HK509/CM3070/README.md

# CM3070 - Final Project

## A.E.R.O - Aqua and Ember Relief Operations: An IoT Platform for Monitoring, Managing, Mitigating and Communicating Floods, Wildfires and Drought 
8.2 Project Idea 2: Towards a Low-cost Resilient Early-warning Natural 
Disaster Monitoring, Notification and Rapid Response Platform
