HK509/CM3070/Test Reports/Sprint 1 Test Cases.docx

Sprint 1 Test Cases

Hardware Assembly - Hardware and Integration Tests

To ensure components are being handled correctly by the ESP8266 microcontrollers for each node

Node 1 – Sensor Node
Test ID | Feature | Test Action | Expected Result | Pass/ Fail
TC - 01 | Ultrasonic sensor (water level sensor) | Place an object exactly 10cm away from the sensor. | The serial monitor prints a reading of 10cm (± 1cm) | PASSED
TC - 02 | Ultrasonic sensor (water level sensor) | Take a reading from the ultrasonic sensor. Fill the water container with 5cm more water. | The serial monitor shows a reading of 5cm increase in water level (distance is 5cm less than original as water level is now 5cm closer to sensor)
TC - 03 | DHT11 – Temperature and Humidity Sensor (Temperature) | Check current room temperature. Print the DHT11 temperature reading to serial monitor | The current room temperature and DHT11 temperature should be the same (± 2°C) | PASSED
TC - 04 | DHT11 – Temperature and Humidity Sensor (Temperature) | Print the DHT11 temperature reading to serial monitor. Then turn on the heating element of fan heater 1m away from the sensor for 2 minutes. | Sensor temperature readings should gradually increase over the two minutes.
TC - 05 | DHT11 – Temperature and Humidity Sensor (Humidity) | Check current room humidity. Print the DHT11 humidity reading to serial monitor | The current room humidity and DHT11 humidity should be the same (± 5%) | PASSED
TC - 06 | DHT11 – Temperature and Humidity Sensor (Humidity) | Print the DHT11 Humidity reading to serial monitor. Then turn on the heating element of fan heater 1m away from the sensor for 2 minutes. | Sensor humidity readings should gradually decrease over the two minutes.
TC-07 | Capacitive Soil Moisture Sensor | Insert capacitive soil moisture sensor in the soil of a dry, not watered plant | Serial Monitor displays a high reading
TC-08 | Capacitive Soil Moisture Sensor | Insert capacitive soil moisture sensor in the soil of a healthy watered plant | Serial Monitor displays a normal reading

Node 2 – Mitigation Node
TC - 09 | Servo Motor (floodgate) | The floodgate (through servo) should initially be disabled | The servo should be at position 0° (off/ deactivated) | PASSED
TC - 10 | Servo Motor (floodgate) | Flash a command to force the servo to open | The servo should be at position 90° (enabled/ activated) | PASSED
TC - 11 | Pump relay (for irrigation system) | Submerge the pump in water and enable the pump | The pump relay should pump water through the tubes and out into the desired container

Node 3 – Alerting Node
TC - 12 | I2C LCD Display | Initialise the display and write “Alert Node” to row 0 | The display clearly renders the text without corruption | PASSED
TC - 13 | Buzzer | Enable the alarm siren and warning alert beep functions | The buzzer should generate loud alarm sounds | PASSED
TC - 14 | LEDs (Status indicators) | Three steps: • Activate the green LED pin HIGH, and both Yellow and red LED pins LOW • Activate the yellow LED pin HIGH, and both green and red LED pins LOW • Activate the red LED pin HIGH, and both green and yellow LED pins LOW | The green LED turns on whilst yellow and red LEDs are off, then the yellow LED turns on whilst green and red LEDs are off, and finally the red LED turns on where the green and yellow LEDs turn off | PASSED

Notes/ Findings

• Mitigation node – both servo and water pump fought for power. When pump is activated for irrigation, then servo for the floodgate begins ‘glitching’. This is because even if the servo (floodgate) position is set, it uses power to remain in that constant position. This was overcome by temporarily disconnecting the servo from its pins (through code) when the irrigation is activated and pump is enabled. Once the irrigation/ water pump has been deactivated, the servo (floodgate) is reconnected to its pins through code. This seems to work, but it means both floodgate and irrigation cannot be activated at the same time. For future: an external power source is required for the irrigation system water pump.

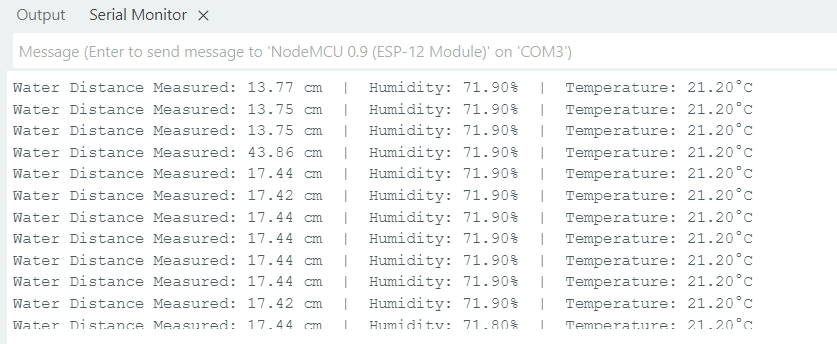
[picture p1: figure]
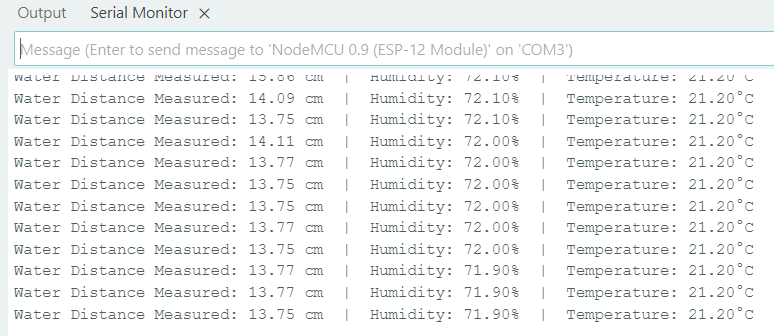
[picture p2: figure]
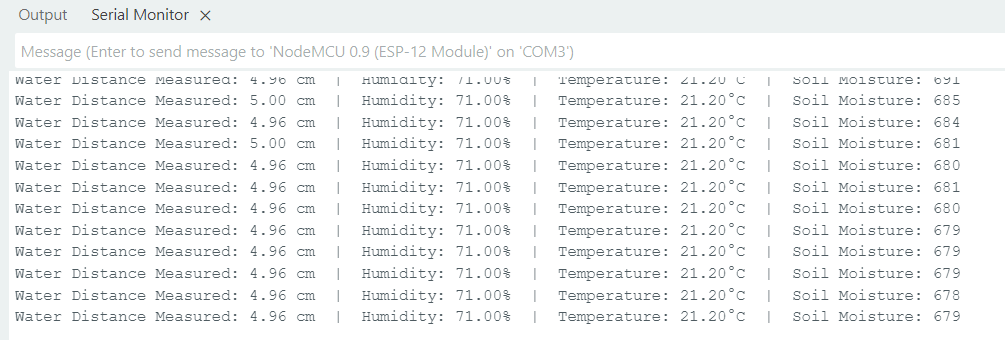
[picture p3: figure]
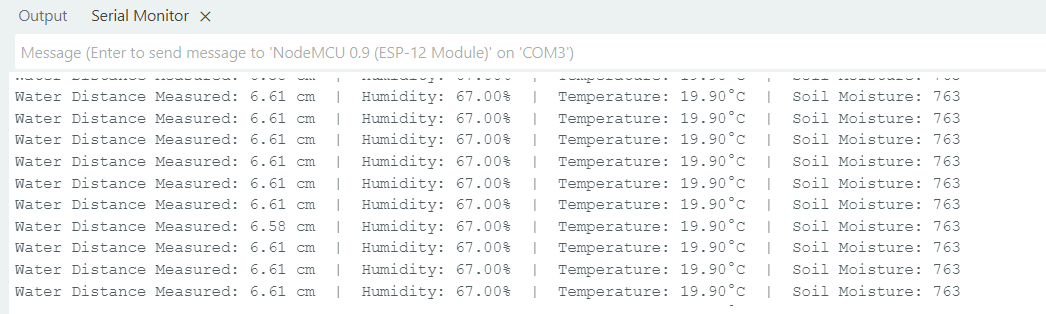
[picture p4: figure]
