HK509/CM3070/Test Reports/Sprint 2 Test Cases.docx

Sprint 2 Test Cases

ESP-NOW Communication – Functional Integration and Logic Tests

To ensure communication is being handled correctly by the ESP8266 microcontrollers for each node

Node 1 – Sensor Node
Test ID | Feature | Test Action | Expected Result | Pass/ Fail
TC - 15 | MAC address discovery | Connect each node to PC and flash MAC address retrieving code | Extract three distinct MAC addresses corresponding to each node | PASSED
TC - 16 | Sensor Node to Alarm Node communication | Send raw sensor data from the Sensor Node to the Alarm Node wirelessly using ESP-NOW | The Alarm node successfully receives the sensor readings and outputs them to its Serial Monitor | PASSED
TC - 17 | Alarm Node to Mitigation Node communication | Send actions to enable and disable the floodgate and irrigation system | The servo (floodgate) should activate and deactivate, and the relay and pump for irrigation system should turn on and off as actions sent | PASSED
TC - 18 | Delivery confirmations (ACK) | Monitor Sensor Node and Alert Node’s Serial Monitors during communications and active transmissions | The transmitting modules print a formal “SUCCESSFUL DELIVERY” (or similar) acknowledgement message for each packet | PASSED
TC - 19 | Connectionless Recovery | Unplug the Alarm Node from power for 10 seconds during active operation, then repower. | Sensor Node re-establishes data transmission without manual resets or intervention | PASSED

Notes/ Findings

• Accidently unplugged Mitigation Node. Alert Node’s Serial Monitor was correctly showing “Delivery Failed”, and when reconnected to power transmission between the Alert Node and the Mitigation Node resumed, the Mitigation Node’s Serial Monitor continued displaying incoming packets sent by the Alert Node.

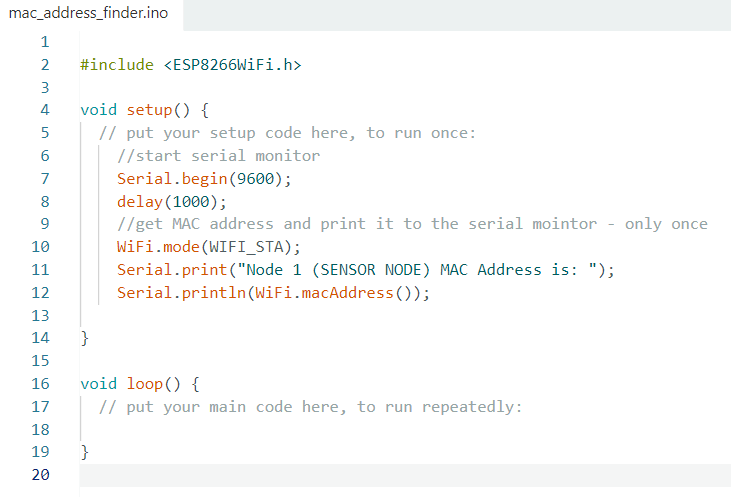
[picture p5: figure]
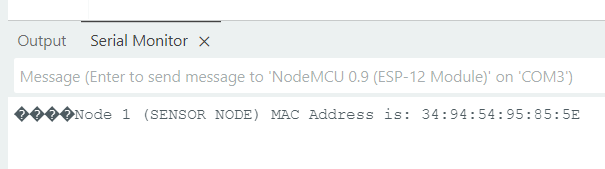
[picture p6: figure]
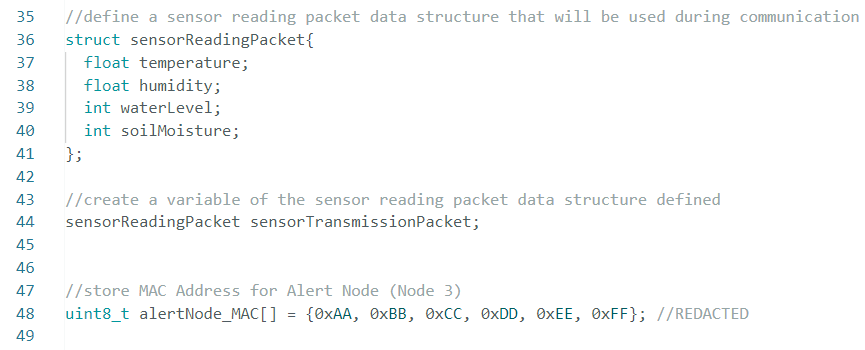
[picture p7: figure]
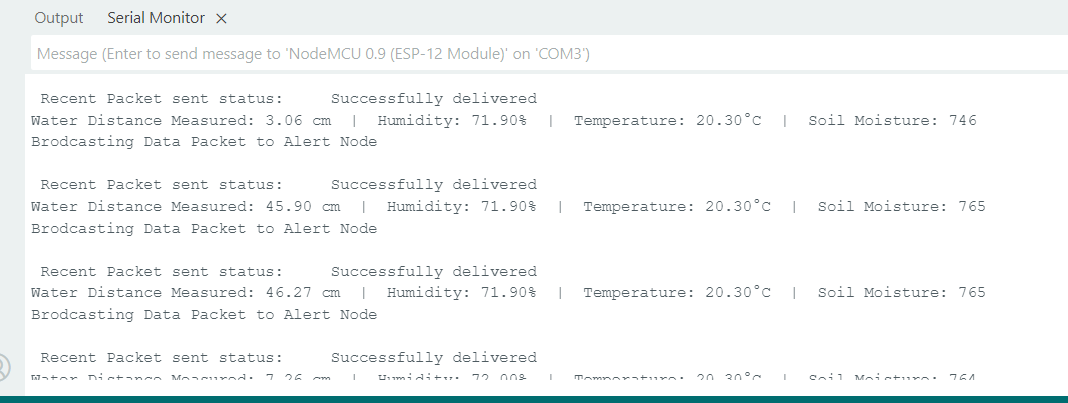
[picture p8: figure]
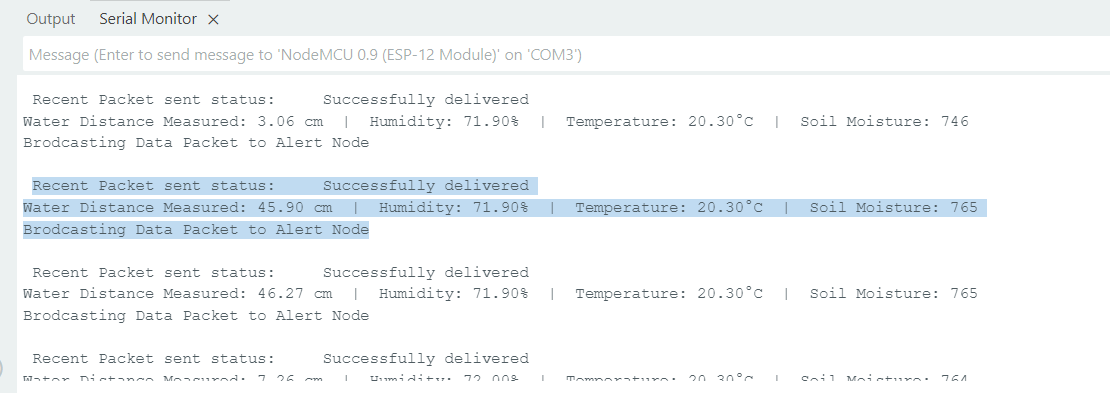
[picture p9: figure]
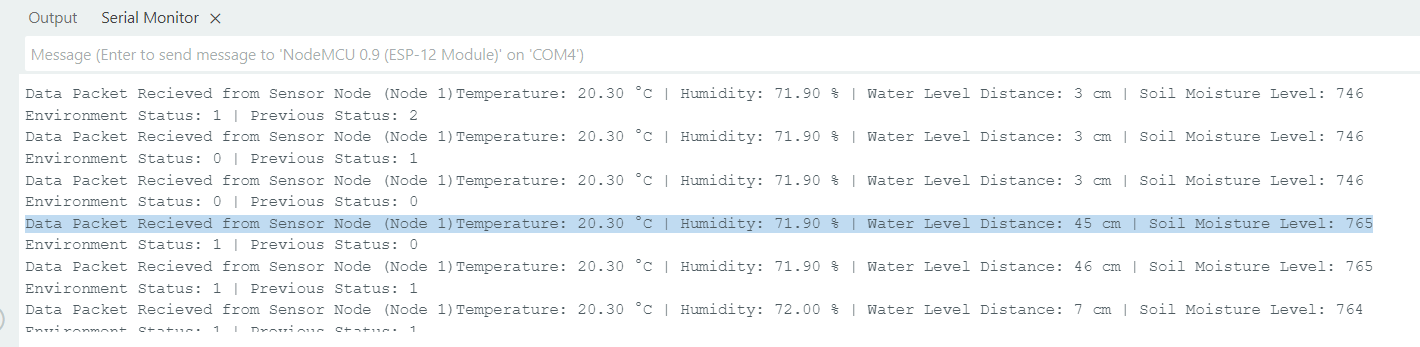
[picture p10: figure]
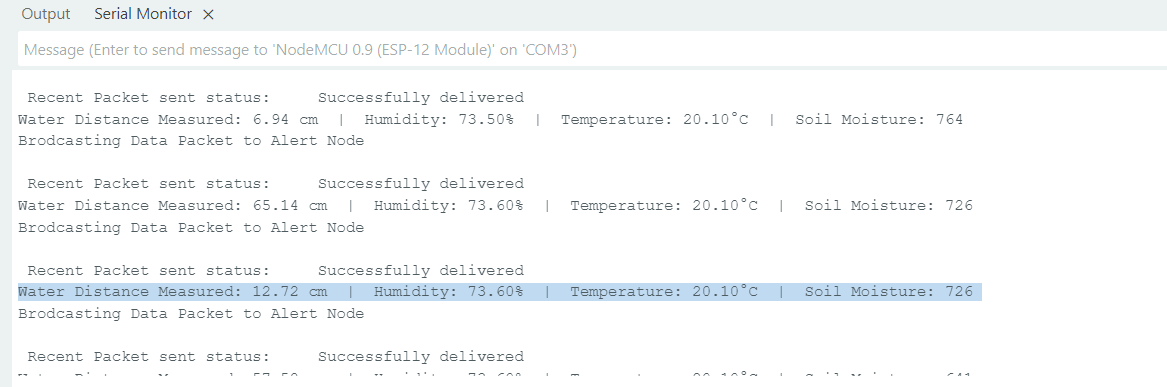
[picture p11: figure]
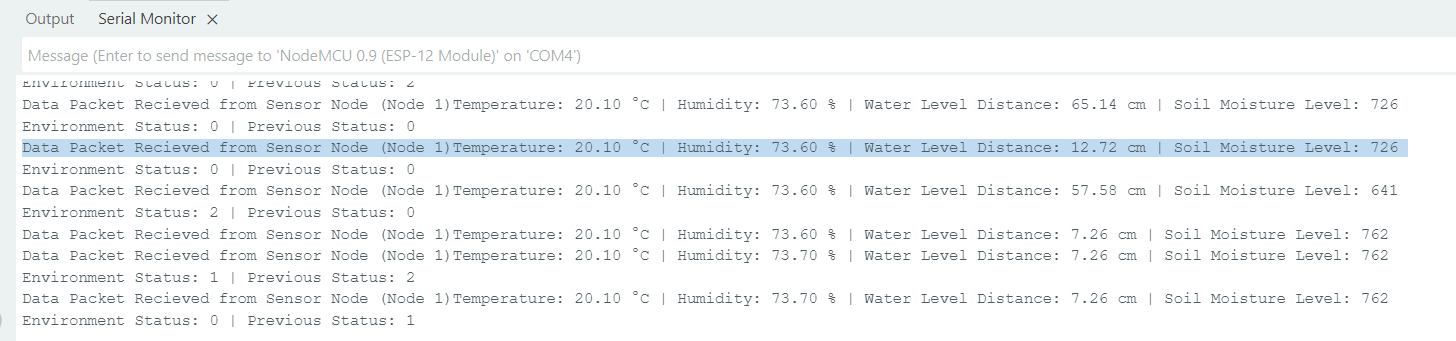
[picture p12: figure]
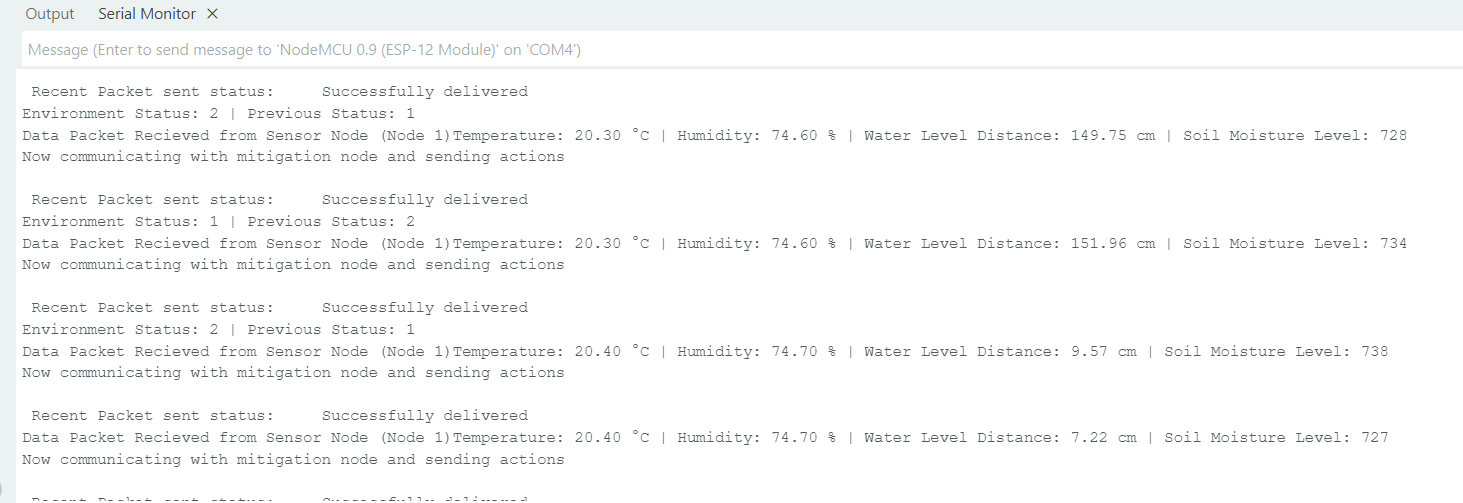
[picture p13: figure]
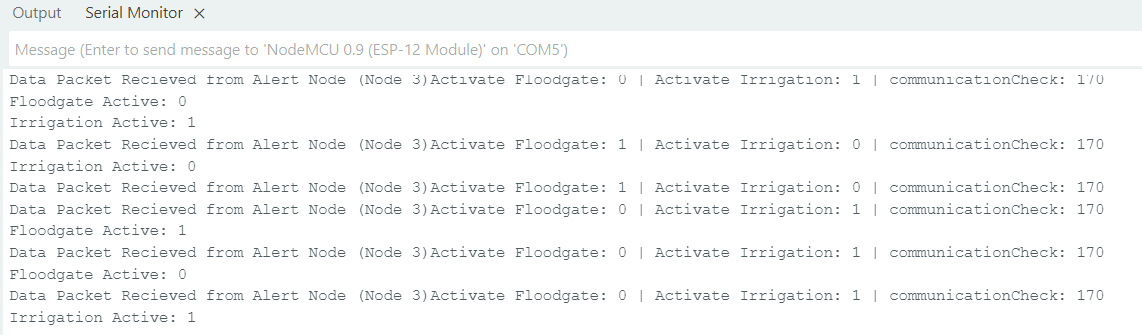
[picture p14: figure]
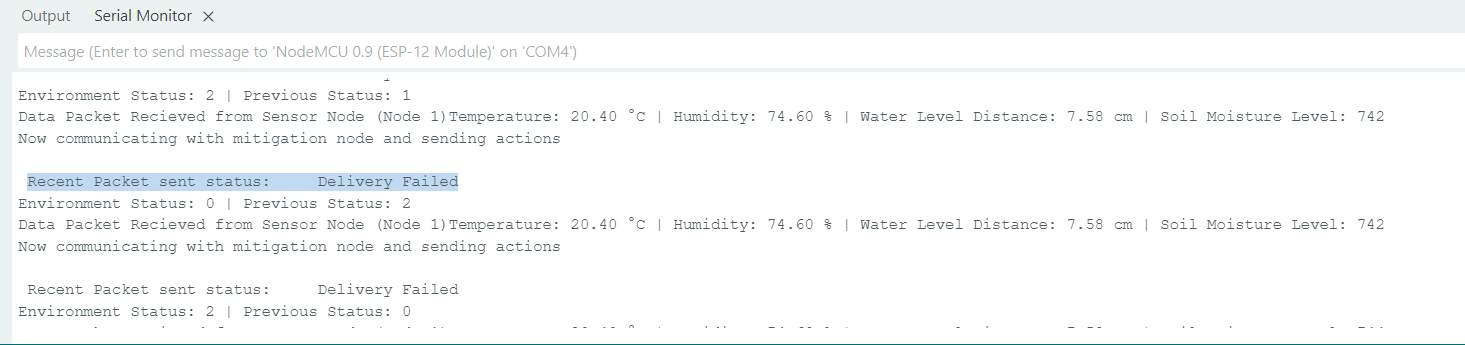
[picture p15: figure]
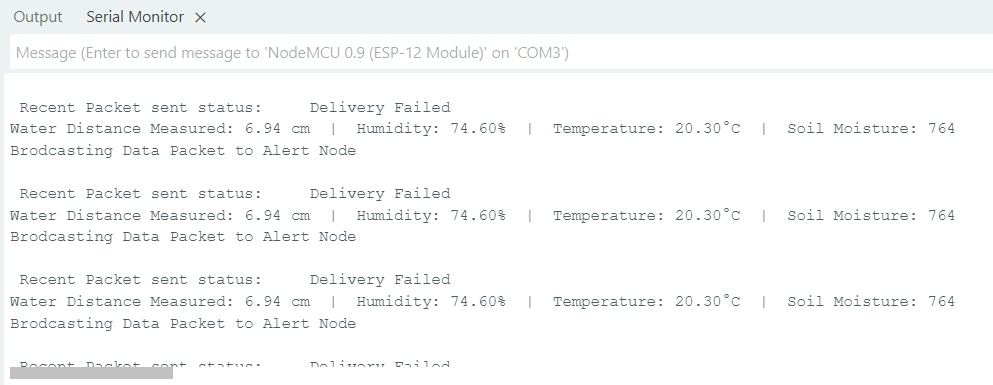
[picture p16: figure]
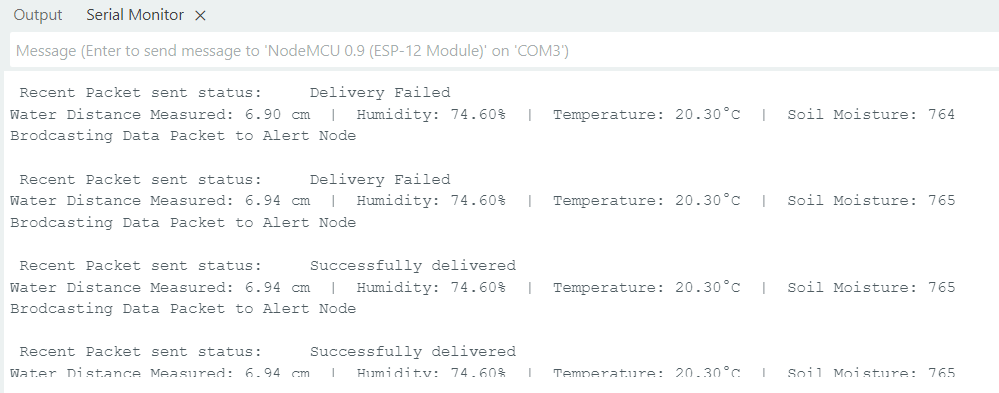
[picture p17: figure]
