HK509/CM3070/Test Reports/Sprint 3 Test Cases.docx

Sprint 3 Test Cases

Fuzzy Logic and Adapdive Sleep Cycles – Functional Integration and Logic Tests

To ensure adaptive logic is being handled correctly by the ESP8266 microcontrollers for each node

Node 1 – Sensor Node
Test ID | Feature | Test Action | Expected Result | Pass/ Fail
TC - 20 | Sensor Node Wake up | Connect a wire between D0 and the RST pin on the Sensor Node | The node wakes up completely by itself for every cycle without intervention | PASSED
TC - 21 | Two-way handshake | Monitor the Serial Monitor of both the Sensor Node and Alert Node when the Sensor Node initially sends its sensor reading data to the Alert Node | The Sensor Node should receive the sleep duration reply from the Alert node before going to sleep | PASSED
TC - 22 | Normal Environment Baseline state | Send normal metrics from the Sensor Node to the Alert Node (low water level, cool temperature, moist soil, regular humidity) | The Fuzzy Logic engine in the Alert Node evaluates this as normal conditions, so the green light turns on, the LCD screen displays “Normal” and a 5 minute sleep time is sent to the sensor node. Both floodgate and irrigation system are deactivated if they already aren’t. | PASSED
TC - 23 | Drought Warning State | Send data from the Sensor Node to the Alert Node with dry soil, low water level, and normal temperature and humidity | The Fuzzy Logic engine in the Alert Node evaluates this as Warning conditions, so the yellow light turns on, the LCD screen displays “WARNING”, a warning beep alarm is played by the buzzer and a 1 minute sleep time is sent to the sensor node. The irrigation system is activated if it isn’t already. | PASSED
TC - 24 | Flood Critical State | Send data from the Sensor Node to the Alert Node with high water levels, but normal for other sensor reading metrics | The Fuzzy Logic engine in the Alert Node evaluates this as Critical conditions, so the red light turns on, the LCD screen displays “CRITICAL”, a continuous siren is played by the buzzer and a 30 second sleep time is sent to the sensor node. The floodgate is enabled if it isn’t already | PASSED
TC - 25 | Wildfire Critical State | Send data with high humidity and low soil moisture from the Sensor Node to the Alert Node | The Fuzzy Logic engine in the Alert Node evaluates this as Critical conditions, so the red light turns on, the LCD screen displays “CRITICAL”, a continuous siren is played by the buzzer and a 30 second sleep time is sent to the sensor node. The irrigation system is disabled for safety | PASSED
TC - 26 | Disaster Priority – Flood and Drought | Send sensor data from the Sensor Node to the Alert Node indicating flood and drought at the same time | The Fuzzy Logic engine in the Alert Node prioritises the flood conditions, activating the floodgate and keeping the irrigation system deactivated. The | PASSED
TC - 27 | Disaster Priority – Wildfires and Flood | Send sensor data from the Sensor Node to the Alert Node indicating flood and wildfire at the same time | The Fuzzy Logic engine in the Alert Node prioritises the wildfire conditions, evaluating as Critical Wildfire conditions. For safety, neither floodgate nor irrigation system is activated (they are kept ) | PASSED

Notes/ Findings

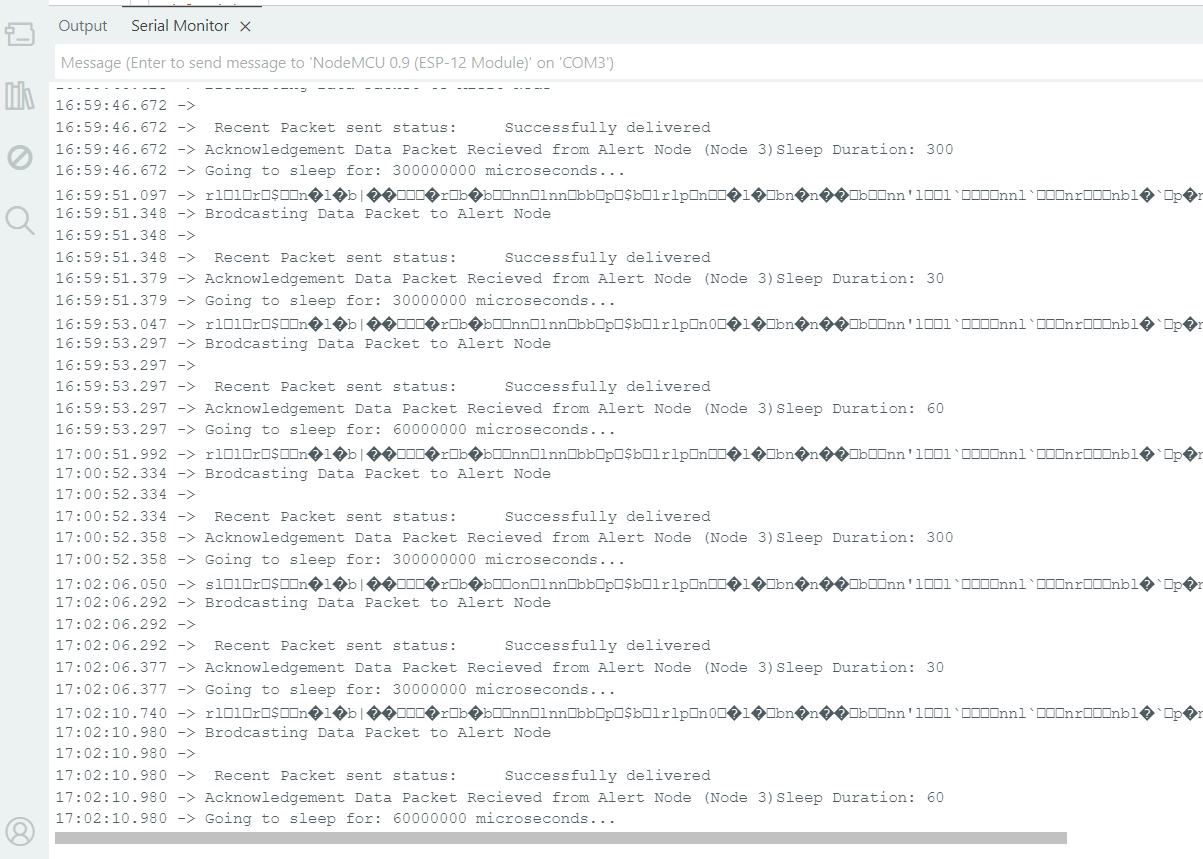
[picture p18: figure]
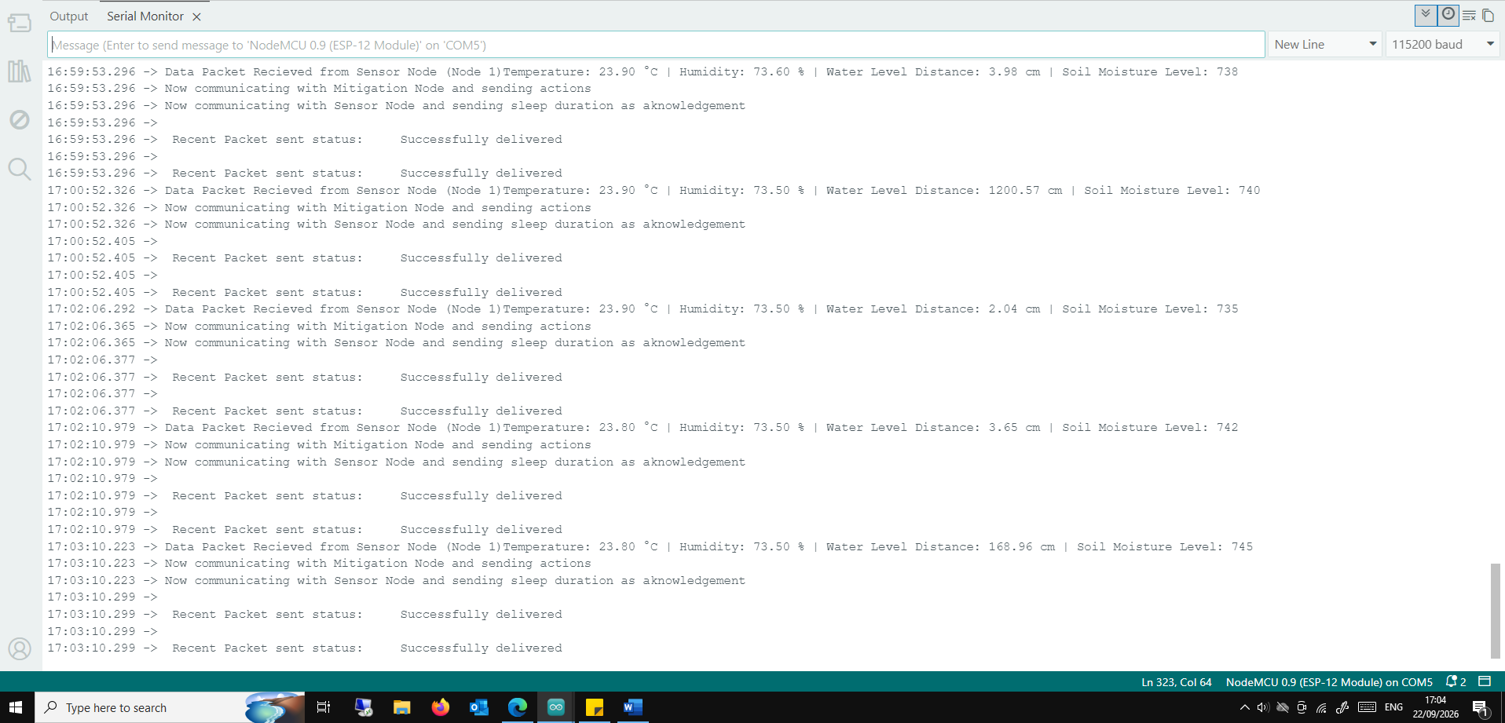
[picture p19: figure]
