HK509/CM3070/Test Reports/Sprint 4 Test Cases.docx

Sprint 4 Test Cases

Node-RED dashboard – Web Interface Testing

To ensure main dashboard and Local Access Points from Alert Node (Node 3) work as intended

Node 1 – Sensor Node
Test ID | Feature | Test Action | Expected Result | Pass/ Fail
TC - 28 | Node-RED Dashboard Update on Received Sensor Reading | Send a force sensor reading from the Sensor Node to the Alert Node by pressing the RST button on the Sensor Node ESP8266 microcontroller. | The dashboard updates in real time and the new sensor reading values can be seen | PASSED
TC - 29 | Node-RED should display current environment status | Send force sensor readings from the Sensor Node to the Alert Node by pressing the RST button on the Sensor Node ESP8266 microcontroller portraying different environment statuses (Normal, WARNING and CRITICAL). The dashboard should clearly update and display the evaluated environment status | The dashboard displays: “Normal”, for the first reading, “WARNING”, for the second reading, and “CRITICAL” for the final reading
TC - 30 | Node-RED should display sensor reading history | Send many force sensor readings from the Sensor Node to the Alert Node by pressing the RST button on the Sensor Node ESP8266 microcontroller | The dashboard should display all sensor readings received with their timestamps and the corresponding environmental conditions
TC - 31 | Weather API | Connect the dashboard to the Weather API and call it at timely increments | The dashboard should show live current weather data retrieved from the API
TC - 32 | Force Environment status change | Change the environment status from “Normal” to “Warning - drought” from the Node-RED dashboard | The Alert Node overrides its environment sensor readings to Warning – drought, sends a message to the mitigation node to activate irrigation, shorten the deep sleep duration for the sensor node. It should illuminate the yellow LED, play the warning beep alarm and display “WARNING” on the LCD screen. The dashboard should reflect the warning | PASSED
TC - 33 | Change fuzzy logic thresholds | Change the thresholds on the Node-RED dashboard (e.g. increase critical water level to 2.5) | The Alert Node should accept the change in threshold and use it for future fuzzy logic calculations | PASSED
TC - 34 | Force Irrigation and floodgate | Press the “Activate Irrigation” on the dashboard | The “Activate Irrigation” button should change to “Deactivate Irrigation”, the “Activate floodgate” should grey out, and the Alert Node should send a message to the Mitigation Node to activate the floodgate | PASSED
TC - 35 | Change deep sleep duration thresholds | Reduce the Normal state deep sleep duration from 300 (5 minutes) to 120 (2 minutes) on the Node-RED dashboard. Then force a sensor reading by pressing the RST button on the Sensor Node’s microcontroller | The sensor node should set its sleep duration to 120 seconds, go to sleep and then wake up after 2 minutes | PASSED
TC - 36 | Twilio SMS Alerts | Press the “send Twilio SMS” button on the dashboard | A SMS should be received on the added phone number

Notes/ Findings

• Node RED is harder than it seems!

• Will come back to it for:

- Displaying environment status and disaster type (as this was implemented later)
- Sensor reading history log
- Add option to toggle Sensor Node deep sleep on or off
- Twilio SMS Alert integration
