HK509/CM3070/Test Reports/Sprint 5 Test Cases.docx

Sprint 5 Test Cases

Local Webserver Dashboard and Fallback Captive Portal – Web Interface Testing

To ensure main dashboard and Local Access Points from Alert Node (Node 3) work as intended

Node 1 – Sensor Node
Test ID | Feature | Test Action | Expected Result | Pass/ Fail
TC - 37 | The dashboards should update on Received Sensor Reading | Send a force sensor reading from the Sensor Node to the Alert Node by pressing the RST button on the Sensor Node ESP8266 microcontroller. | The local webserver dashboard and captive portal dashboard updates in real time and the new sensor reading values can be seen | PASSED
TC - 38 | The dashboards should display current environment status | Send force sensor readings from the Sensor Node to the Alert Node by pressing the RST button on the Sensor Node ESP8266 microcontroller by placing the ultrasonic distance sensor at different hights to portray normal, warning and critical flood conditions | The dashboard displays: “Normal”, for the first reading, “WARNING”, for the second reading, and “CRITICAL” for the final reading | PASSED
TC - 39 | The dashboard should display sensor reading history | Send many force sensor readings from the Sensor Node to the Alert Node by pressing the RST button on the Sensor Node ESP8266 microcontroller | The history sensor reading page should display all sensor readings received with their timestamps and the corresponding environmental conditions | PASSED
TC - 40 | Force Environment status change | Change the environment status from “Normal” to “Warning - drought” from the Node-RED dashboard | The Web dashboard should display “Warning-drought” and the corresponding guidance actions | PASSED
TC - 41 | The dashboard should refresh after 2 minutes | Force a sensor reading simulating different conditions and wait for a maximum of two minutes | The dashboard should update with this new sensor reading and display the new environment condition and corresponding guidance instructions. This sensor reading should also be displayed in the history page | PASSED
TC - 42 | The dashboard should dynamically show guidance instructions based on the environment conditions where required | Force a sensor reading simulating different conditions and wait for a maximum of two minutes | The main index page should display the guidance text for warning and critical conditions | PASSED

Notes/ Findings

• Packets failed to be received and delivered by the alert node when the wireless Access Point captive portal mode was used.

• The WiFi connections options display ‘FaryLink_xxx’ corresponding to the manufacturer hard-coded access point link when Wi-Fi is connected.
