HK509/CM3070/Sensor_Node.ino

//Libraries for ESP-NOW communication
#include <ESP8266WiFi.h>
#include <espnow.h>

//library for DHT11 Temperature and Humidity Sensor
#include "DHT.h"


//define ultrasonic distance sensor pins - trigger and echo
const int TRIG_PIN = D5;
const int ECHO_PIN = D6;

//define DHT11 pin and sensor type
const int DHT_PIN = D7;
const uint8_t DHT_TYPE = DHT11;
//create a object (DHT11)
DHT dht11_sensor(DHT_PIN, DHT_TYPE);

//define Soil moisture sensor pin
const int SOIL_MOISTURE_PIN = A0;


//ultrasonic sensor reading storage variable - water level distance
float waterLevel_distance;

//DHT11 sensor reading storage data type and variable - temperature and humidity
struct dht11Data{
  float temperature;
  float humidity;
};
dht11Data dht11_temp_humidity;

//soil moisture sensor reading storage veriable
float soilMoisture_level;



//define a sensor reading packet data structure that will be used during communication with the Alert Node
struct sensorReadingPacket{
  float temperature;
  float humidity;
  float waterLevel;
  int soilMoisture;
};

//create a variable of the sensor reading packet data structure defined that will be sent to the Alert Node
sensorReadingPacket sensorTransmissionPacket;


//define a sleep duration packet data structure that will be recieved as acknowledgement from the Alert Node to the sensor reading packet it recieves
struct sleepDurationPacket{
  int sleepDuration;
};

//create a variable of the recieved sleep duration packet data structure defined that will be recieved from the Alert Node as acknowledgement
sleepDurationPacket recievedSleepDurationPacket;

//create a sleep duration variable
int sleepDurationCalculated;

//create a boolean variable that determines if the Alert Node has sent the sleep duration as acknowledgement
bool sleepDurationRecieved = false;



//store MAC Address for Alert Node (Node 3)
uint8_t alertNode_MAC[] = {0xAA, 0xBB, 0xCC, 0xDD, 0xEE, 0xFF}; //REDACTED


//ESP-NOW transmission delivery feedback callback handler when data is sent
//This function automatically executes the moment the node attempts to transmit data packets
void onDataSent(uint8_t *mac_addr, uint8_t sentStatus){
  Serial.print("\r\n Recent Packet sent status: \t");
  Serial.println(sentStatus == 0 ? "Successfully delivered" : "Delivery Failed");
}


// Automatically triggers whenever Alert Node (Node 3) sends a message packet (acknowledgement through the sleep duration)
void onDataRecv(uint8_t * mac, uint8_t *incomingByte, uint8_t len) {
  
  // Unpack incoming bytes back into structured reading values
  memcpy(&recievedSleepDurationPacket, incomingByte, sizeof(recievedSleepDurationPacket));
  
  // Print results to serial monitor
  Serial.print("Acknowledgement Data Packet Recieved from Alert Node (Node 3)");
  Serial.print("Sleep Duration: "); 
  Serial.println(recievedSleepDurationPacket.sleepDuration);

  sleepDurationCalculated = recievedSleepDurationPacket.sleepDuration;
  sleepDurationRecieved = true;

}




void setup() {
  // put your setup code here, to run once:

  //begin serial monitor at 115200
  Serial.begin(115200);

  //wake up the external built-in antenna in the esp8266 and set it into WiFi station mode which is required for ESP-NOW
  WiFi.forceSleepWake();
  delay(10);
  WiFi.mode(WIFI_STA);
  wifi_set_channel(1);

  //configure the ultrasonic sensor pins: trigger pin to output mode and echo pin to input
  pinMode(TRIG_PIN, OUTPUT);
  pinMode(ECHO_PIN, INPUT);

  //initialise DHT11 sensor
  dht11_sensor.begin();


  //set acknowledgement recieved from the Alert Node as false;
  sleepDurationRecieved = false;

  //calculate water level by calling the measureWaterLevel function to read ultrasonic distance sensor
  waterLevel_distance = measureWaterLevel();
  
  //get temperature and humidity levels
  dht11_temp_humidity = measureTempHumidity();

  //get soil moisture level
  soilMoisture_level = measureSoilMoisture();


  //now prepare the data packet for transmission
  sensorTransmissionPacket.temperature = dht11_temp_humidity.temperature;
  sensorTransmissionPacket.humidity = dht11_temp_humidity.humidity;
  sensorTransmissionPacket.waterLevel = waterLevel_distance;
  sensorTransmissionPacket.soilMoisture = soilMoisture_level;


  //check ESP-NOW connection if failed, add message to serial monitor
  if (esp_now_init() != 0) {
    Serial.println("ESP-NOW Init Failed");
  }

  //set device role as both sender and reciever (combo) 
  esp_now_set_self_role(ESP_NOW_ROLE_COMBO);

  //register the sending transmission callback function defined
  esp_now_register_send_cb(onDataSent);

  //register the Alert Node (3) as a reciever 
  //Settings: (MAC Address, Device Role, Wi-Fi Channel 1, No Security Key, Key Length 0)
  esp_now_add_peer(alertNode_MAC, ESP_NOW_ROLE_COMBO, 1, NULL, 0); 

  //register the recieving transmission callback function defined
  esp_now_register_recv_cb(onDataRecv);



  Serial.println("Brodcasting Data Packet to Alert Node");

  //now transmit the data packet
  esp_now_send(alertNode_MAC, (uint8_t *) &sensorTransmissionPacket, sizeof(sensorTransmissionPacket));


  //now wait for the acknowledgement from the Alert Node containing sleep duration to be recieved
  //create a timer using miliseconds
  unsigned long timer = millis();
  while (millis() - timer < 3000){
    if(sleepDurationRecieved == true){
      break;
    }
    delay(1); 
  }

  //if not recieved after 3 seconds, then go to sleep for short time and then wake up, so set sleep duration to 10 seconds
  if(sleepDurationRecieved == false){
    sleepDurationCalculated = 10;
  }
  
  //now convert from seconds to milliseconds by multiplying by 1000000 (unsigned long long)
  uint64_t convertedSleepDuration = uint64_t(sleepDurationCalculated) * 1000000ULL;

  //now go to sleep
  Serial.print("Going to sleep for: ");
  Serial.print(convertedSleepDuration);
  Serial.println(" microseconds...");
  // Sleep safely for the calculated time with RF disabled at startup to prevent brownouts (drops in voltages) over USB 
  ESP.deepSleep(convertedSleepDuration, WAKE_RF_DEFAULT);


}


//loop function is empty as not used - setup function will be called everytime the node wakes up
void loop() {
  // put your main code here, to run repeatedly:

  

}



//ultrasonic distance sensor reading function - water level
float measureWaterLevel(){

  // Take ultrasonic distance data
  digitalWrite(TRIG_PIN, LOW);
  delayMicroseconds(2);
  digitalWrite(TRIG_PIN, HIGH);
  delayMicroseconds(10);
  digitalWrite(TRIG_PIN, LOW);
  
  long duration = pulseIn(ECHO_PIN, HIGH);
  float calculatedDistance = duration * 0.034 / 2; //multiply by half of speed of sound
  
  Serial.print("Water Distance Measured: ");
  Serial.print(calculatedDistance);
  Serial.print(" cm  |  ");

  return calculatedDistance;
}

//DHT11 sensor reading function - temperature and humidity
dht11Data measureTempHumidity(){
  dht11Data readings;

  //read temperature
  float temperature = dht11_sensor.readTemperature();

  //read humidity
  float humidity = dht11_sensor.readHumidity();



  //check readings are successfull
  if(isnan(temperature) || isnan(humidity)){
    Serial.println("DHT11 readings failed!");
  }
  else{
    Serial.print("Humidity: ");
    Serial.print(humidity);
    Serial.print("%");

    Serial.print ("  |  ");

    Serial.print("Temperature: ");
    Serial.print(temperature);
    Serial.print("°C  |  ");

    readings.temperature = temperature;
    readings.humidity = humidity;
  }

  return readings;
}



//soil moisture sensor reading function
float measureSoilMoisture(){
  int soilMoistureValue = analogRead(SOIL_MOISTURE_PIN);

  Serial.print("Soil Moisture: ");
  Serial.println(soilMoistureValue);

  return soilMoistureValue;
}
